leorayjes/usb-ddr-dance-pad/pics/pad_1.jpg

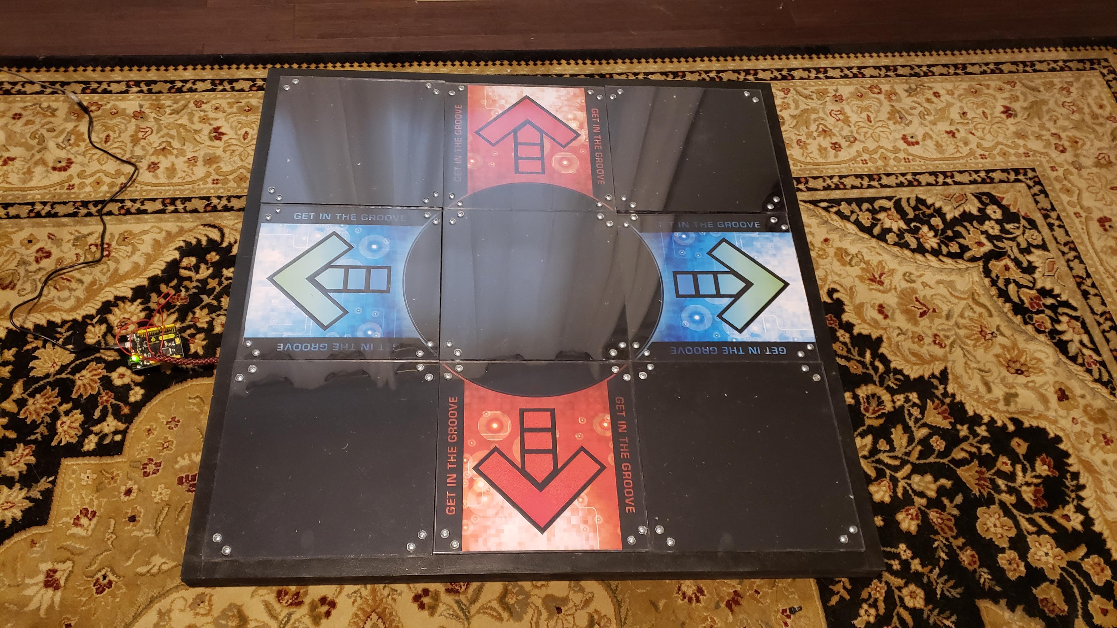
pics/pad_1.jpg
