leorayjes/usb-ddr-dance-pad/pics/pad_2.jpg

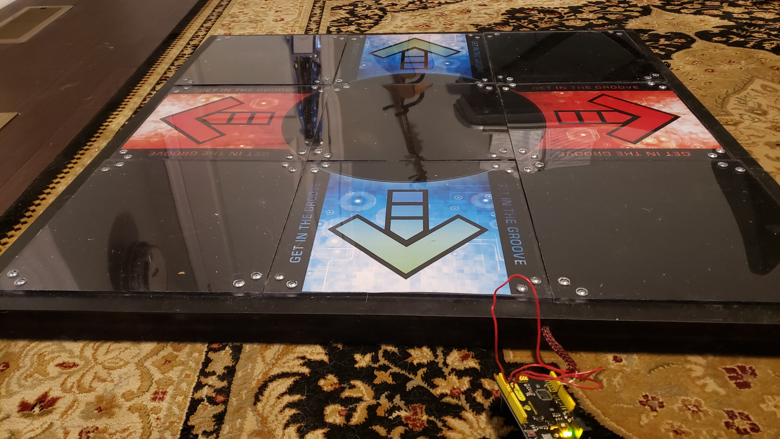
pics/pad_2.jpg
