leorayjes/usb-ddr-dance-pad/pics/ardiuno.jpg

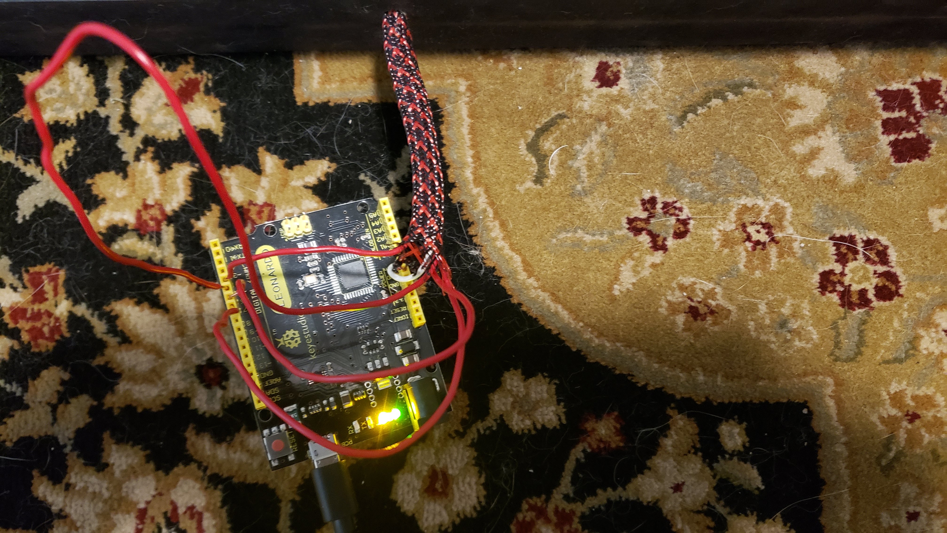
pics/ardiuno.jpg
