leorayjes/usb-ddr-dance-pad/graphics/pdf/arrow_print_template.pdf

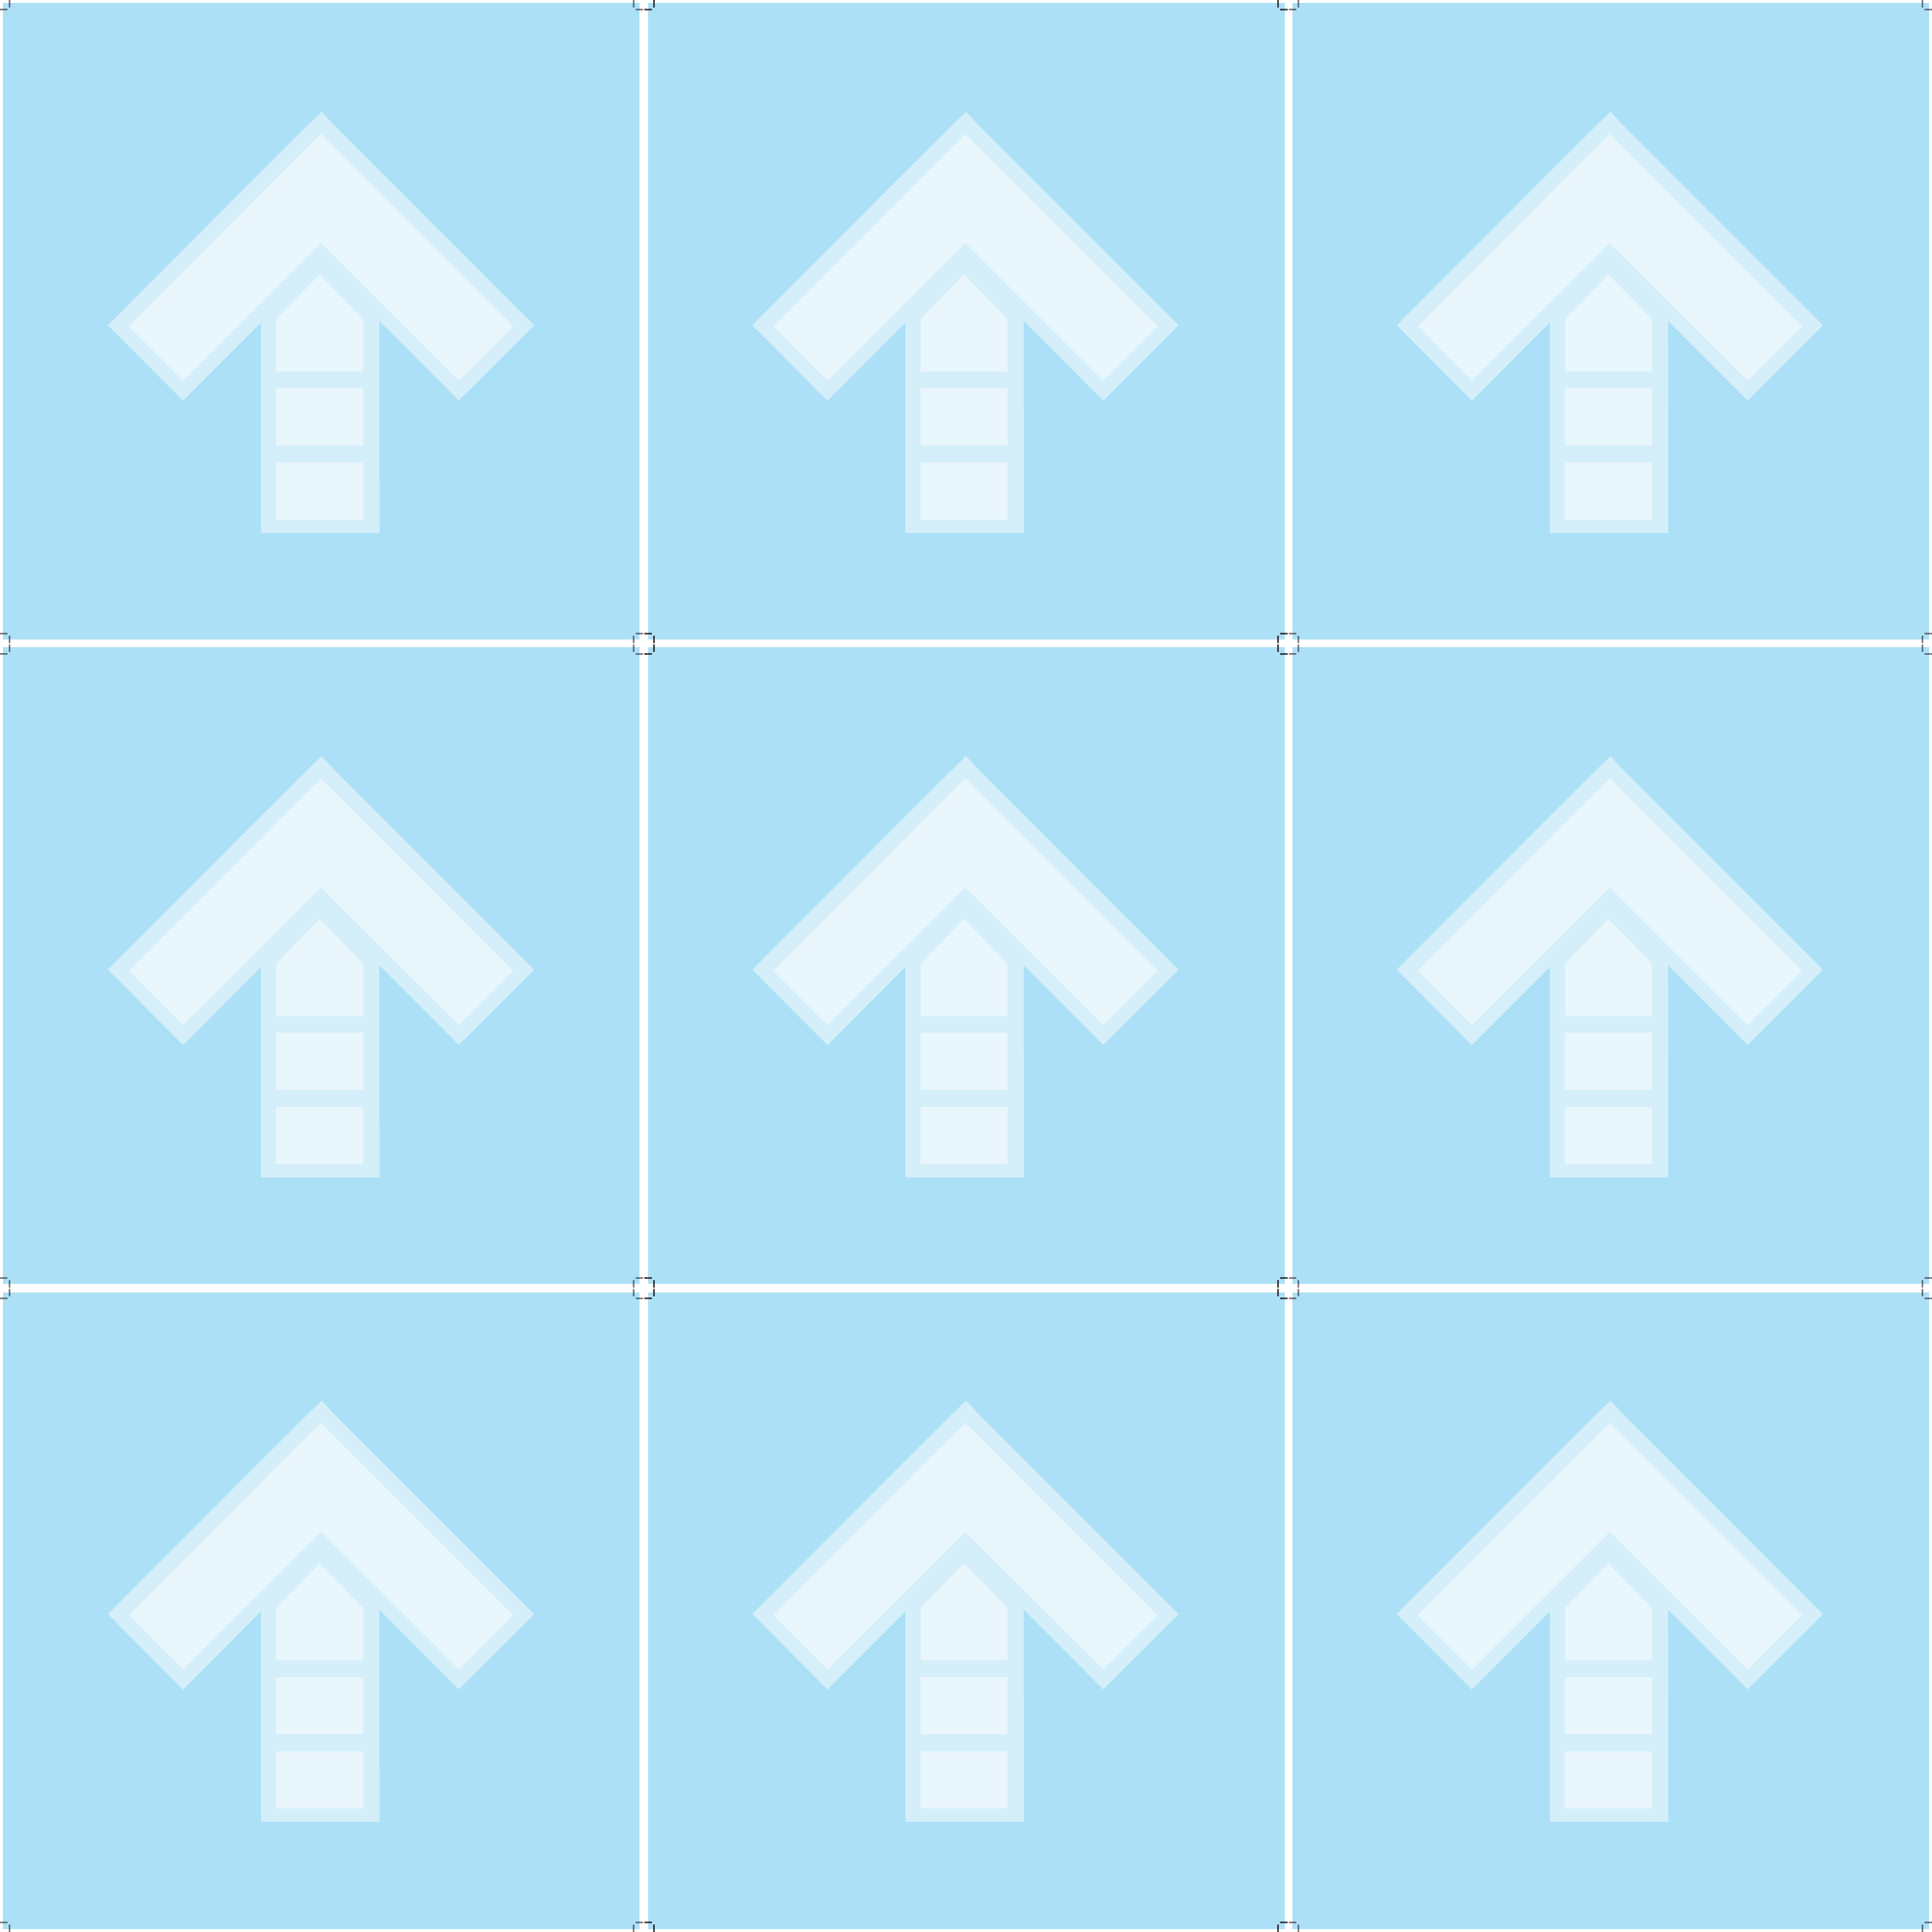
[picture p4: page 1]
