leorayjes/usb-ddr-dance-pad/graphics/pdf/blue_arrow_single.pdf

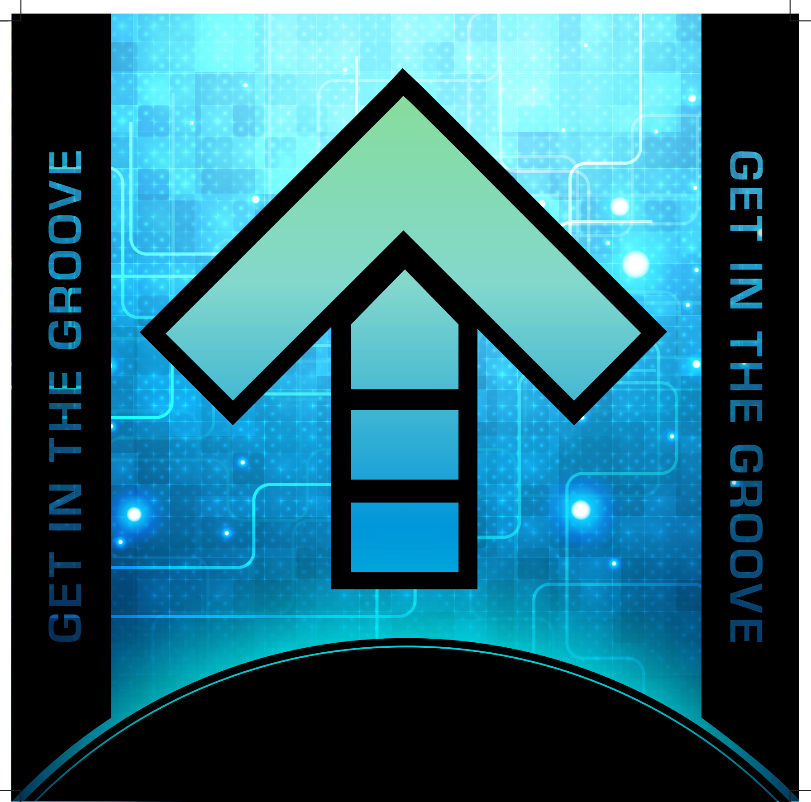
[picture p5: page 1]
