leorayjes/usb-ddr-dance-pad/graphics/pdf/red_arrow_single_no_border.pdf

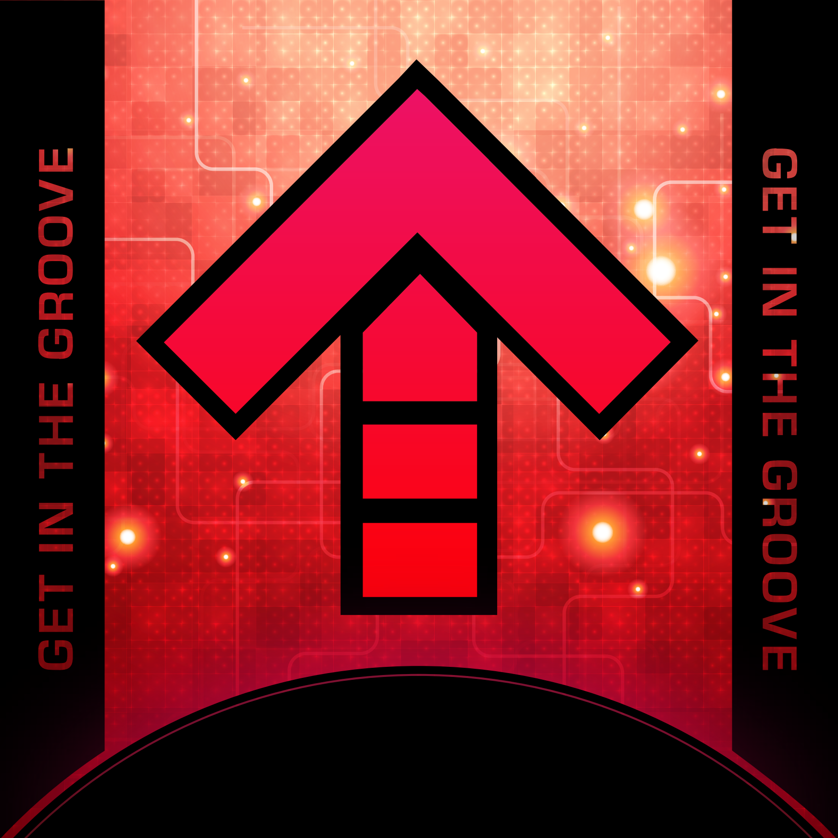
[picture p6: page 1]
